bikerglen/halloween-grave-bell/mech/grave-bell-roof.dxf

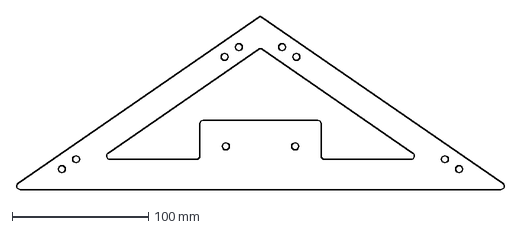
[picture p1: CAD file, 2021-09-14]
mech/grave-bell-roof.dxf
357.7 x 127.0 mm
