bikerglen/halloween-grave-bell/mech/ultrasonic sensor mount.dxf

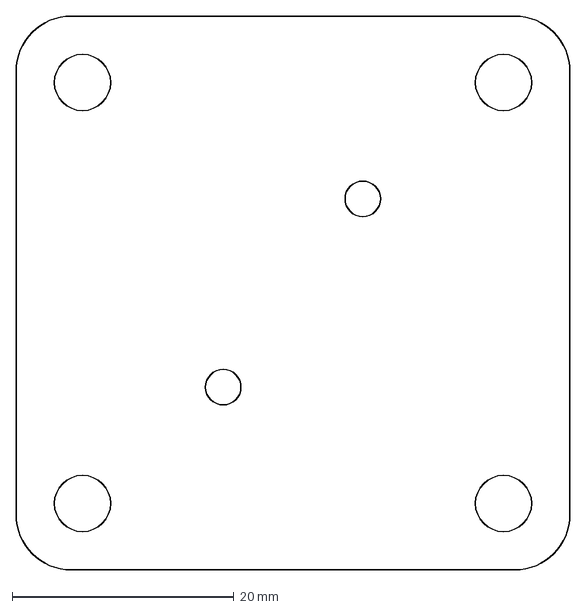
[picture p2: CAD file, 2021-09-14]
mech/ultrasonic sensor mount.dxf
50.0 x 50.0 mm
