bikerglen/halloween-grave-bell/mech/db9 power connector mount.dxf

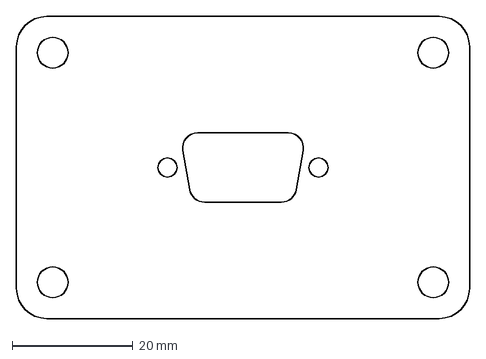
[picture p3: CAD file, 2021-09-14]
mech/db9 power connector mount.dxf
75.0 x 50.0 mm
