bikerglen/halloween-grave-bell/mech/board mount.dxf

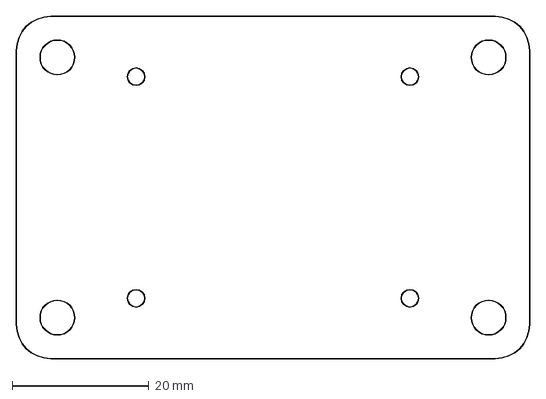
[picture p4: CAD file, 2021-09-14]
mech/board mount.dxf
75.0 x 50.0 mm
