bikerglen/halloween-grave-bell/hw/halloween-grave-bell-v02.brd

## EAGLE design hw/halloween-grave-bell-v02.brd (2021-09-05)

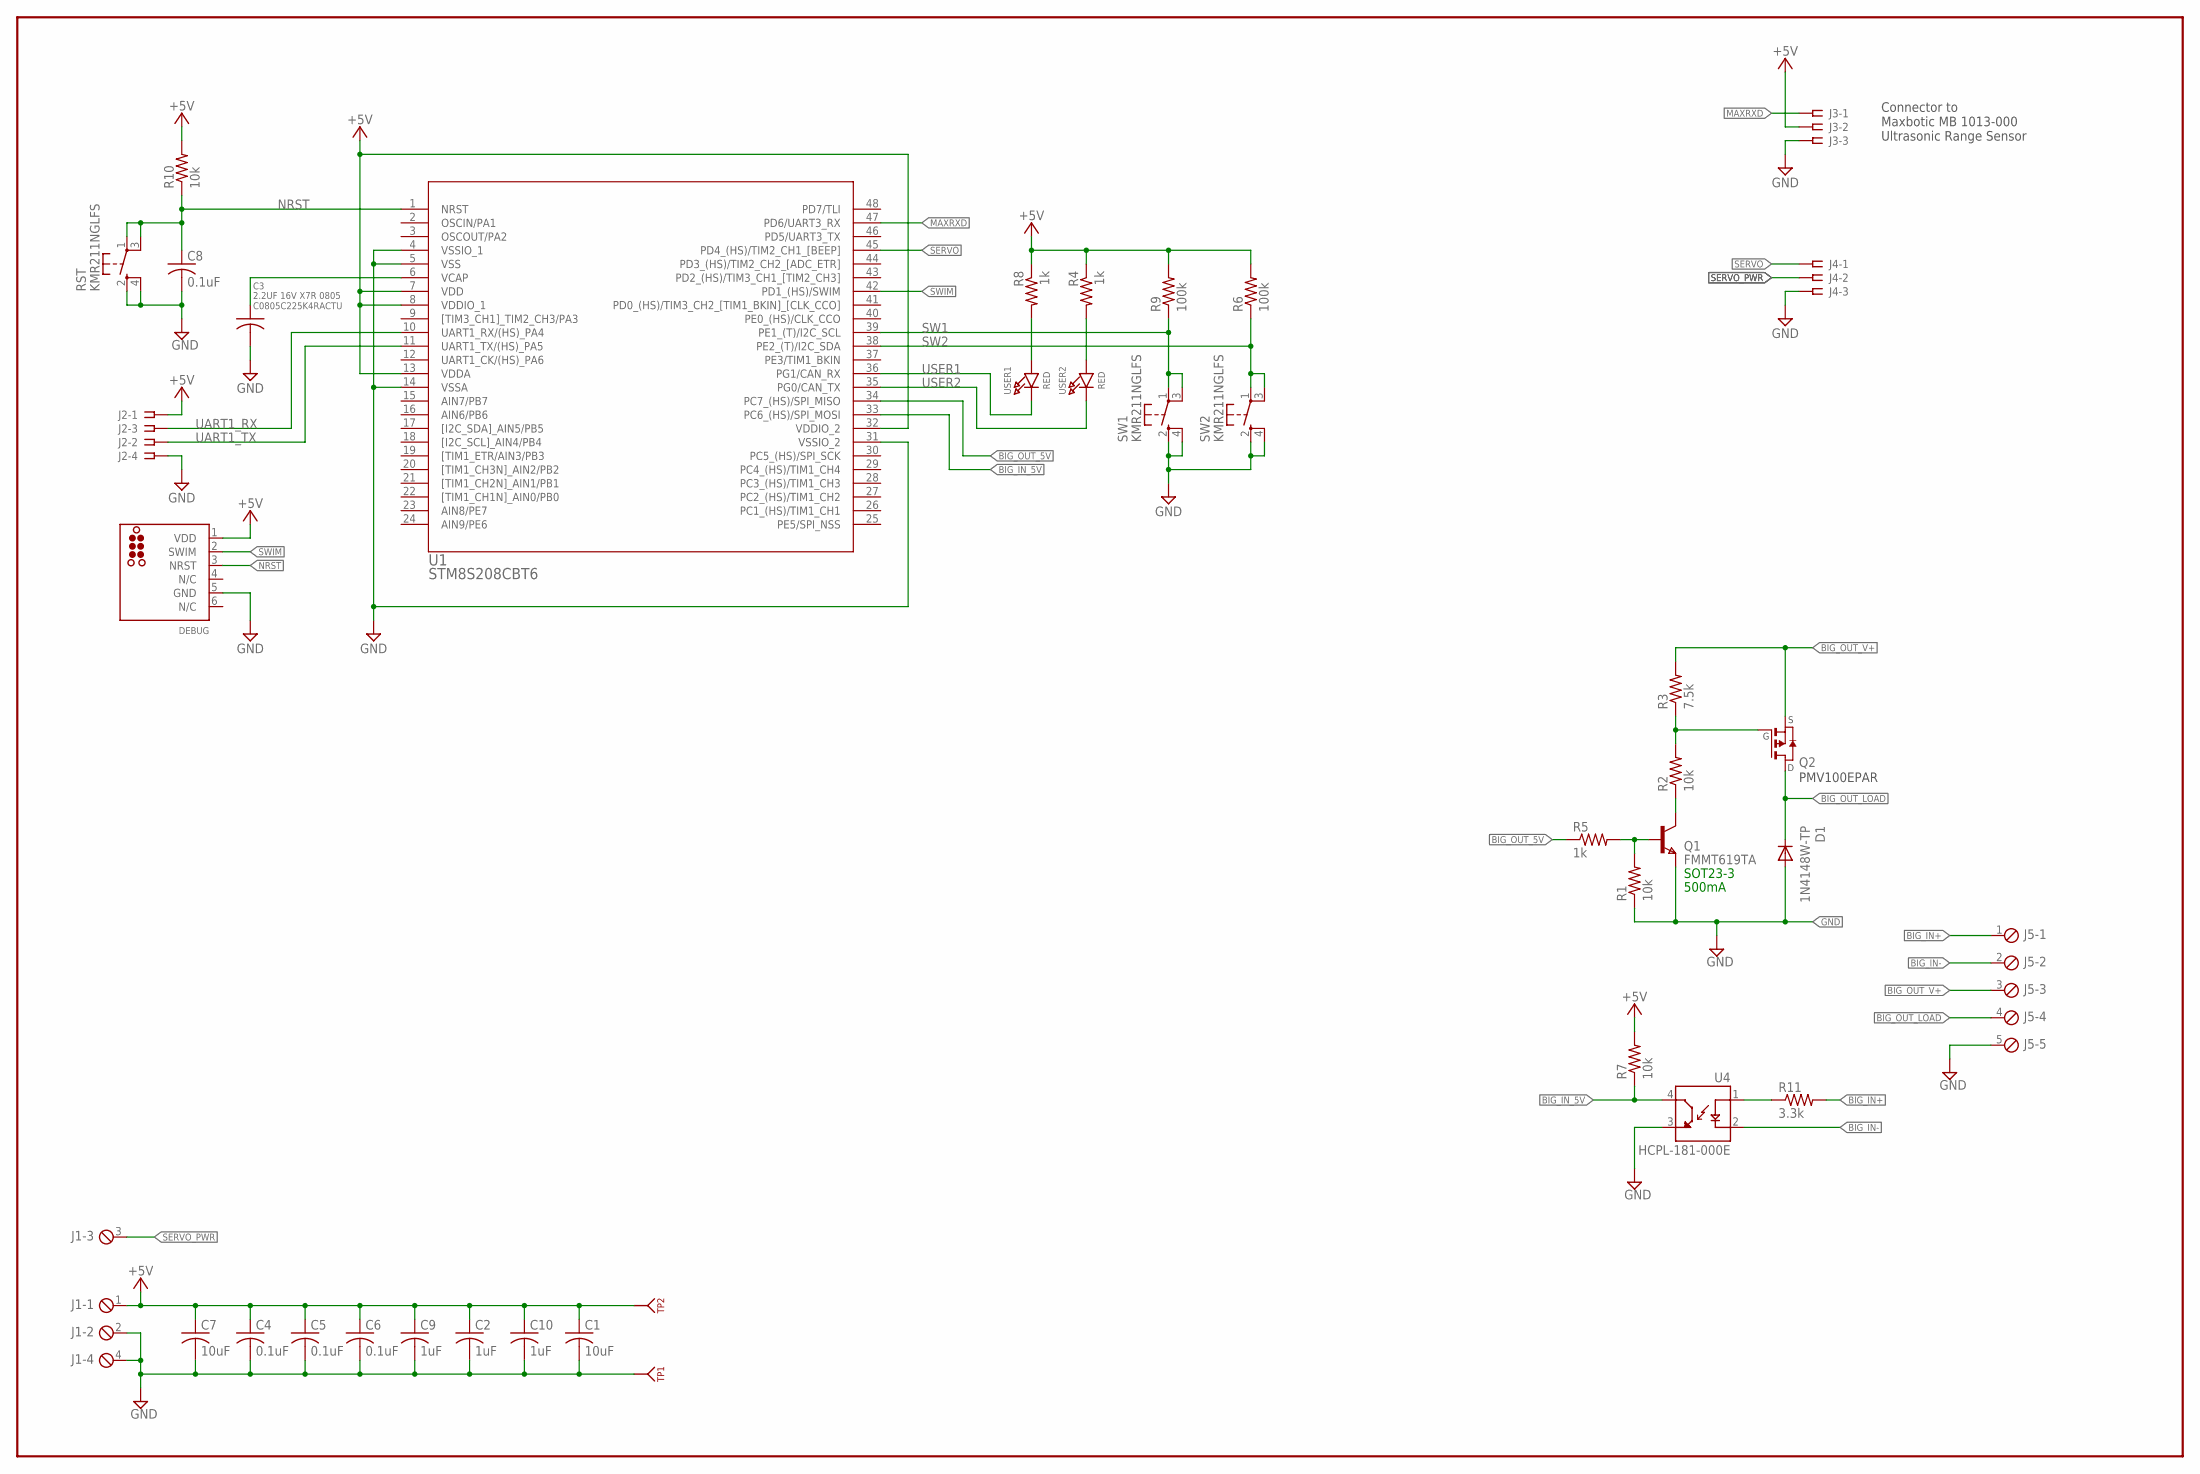
[picture p5: schematic halloween-grave-bell-v02.sch]

Parts:
C1, C7: 10uF; C1210; MFR_PART_NO C1210C105K4PACTU
C2, C9, C10: 1uF; C0603
C3: 2.2UF 16V X7R 0805; C0805; MFR_PART_NUM C0805C225K4RACTU
C4, C5, C6: 0.1uF; C0603
C8: 0.1uF; C0805
D1: 1N4148W-TP; SOD123
DEBUG: TC2030-NL-STM8; TC2030-NL
J1: MPT4; 4POL254
J2: SSW-104-02-S-S
J3, J4: SSW-103-02-S-S
J5: MPT5; 5POL254
Q1: FMMT619TA; SOT-23
Q2: PMOSSOT23; SOT-23
R1, R2, R7: 10k; R0603
R3: 7.5k; R0603
R4, R8: 1k; R0805
R5: 1k; R0603
R6, R9: 100k; R0805
R10: 10k; R0805
R11: 3.3k; R0603
RST: KMR211NGLFS; KMR2
SW1, SW2: KMR211NGLFS; KMR2
TP1, TP2: KEYSTONE_500X; KEYSTONE_TP500X
U1: STM8S208CBT6; LQFP-48_STM
U4: HCPL-181-000E; SOIC254P675X240-4N
USER1, USER2: RED; CHIPLED_0805_NOOUTLINE

Connections:
+5V: C1.1, C2.1, C4.1, C5.1, C6.1, C7.1, C9.1, C10.1, DEBUG.1 (VDD), J1.1, J2.1, J3.2, R4.1, R6.2, R7.2, R8.1, R9.2, R10.2, TP2.1, U1.7 (VDD), U1.8 (VDDIO_1), U1.13 (VDDA), U1.32 (VDDIO_2)
BIG_IN+: J5.1, R11.2
BIG_IN-: J5.2, U4.2 (CATHODE)
BIG_IN_5V: R7.1, U1.33 (PC6_(HS)/SPI_MOSI), U4.4 (COLLECTOR)
BIG_OUT_5V: R5.1, U1.34 (PC7_(HS)/SPI_MISO)
BIG_OUT_LOAD: D1.C, J5.4, Q2.1 (D)
BIG_OUT_V+: J5.3, Q2.2 (S), R3.2
GND: C1.2, C2.2, C3.2, C4.2, C5.2, C6.2, C7.2, C8.2, C9.2, C10.2, D1.A, DEBUG.5 (GND), J1.2, J1.4, J2.4, J3.3, J4.3, J5.5, Q1.2 (E), R1.1, RST.2 (S), RST.4 (S1), SW1.2 (S), SW1.4 (S1), SW2.2 (S), SW2.4 (S1), TP1.1, U1.4 (VSSIO_1), U1.5 (VSS), U1.14 (VSSA), U1.31 (VSSIO_2), U4.3 (EMITTER)
MAXRXD: J3.1, U1.47 (PD6/UART3_RX)
unnamed: Q1.1 (C), R2.1
unnamed: R8.2, USER1.A
unnamed: Q2.3 (G), R2.2, R3.1
unnamed: R4.2, USER2.A
unnamed: R11.1, U4.1 (ANODE)
unnamed: Q1.3 (B), R1.2, R5.2
NRST: C8.1, DEBUG.3 (NRST), R10.1, RST.1, RST.3 (P1), U1.1 (NRST)
SERVO: J4.1, U1.45 (PD4_(HS)/TIM2_CH1_[BEEP])
SERVO_PWR: J1.3, J4.2
SW1: R9.1, SW1.1, SW1.3 (P1), U1.39 (PE1_(T)/I2C_SCL)
SW2: R6.1, SW2.1, SW2.3 (P1), U1.38 (PE2_(T)/I2C_SDA)
SWIM: DEBUG.2 (SWIM), U1.42 (PD1_(HS)/SWIM)
UART1_RX: J2.3, U1.10 (UART1_RX/(HS)_PA4)
UART1_TX: J2.2, U1.11 (UART1_TX/(HS)_PA5)
USER1: U1.36 (PG1/CAN_RX), USER1.C
USER2: U1.35 (PG0/CAN_TX), USER2.C
VCAP: C3.1, U1.6 (VCAP)

Notes on the sheet:
SOT23-3
500mA
‎PMV100EPAR‎
Connector to Maxbotic MB 1013-000 Ultrasonic Range Sensor

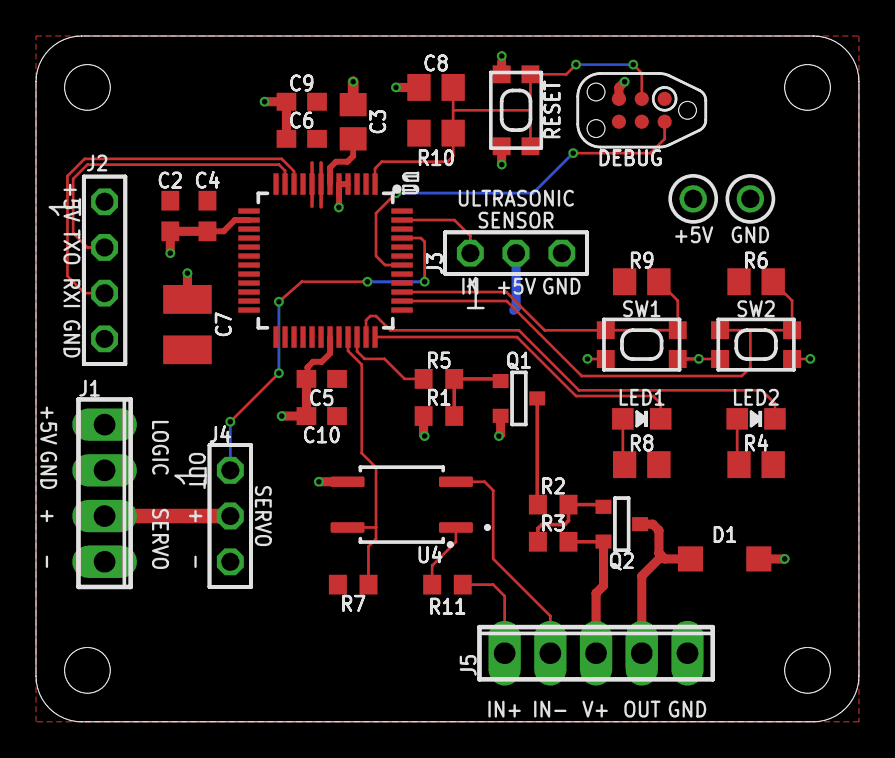
[picture p6: board halloween-grave-bell-v02.brd from above]

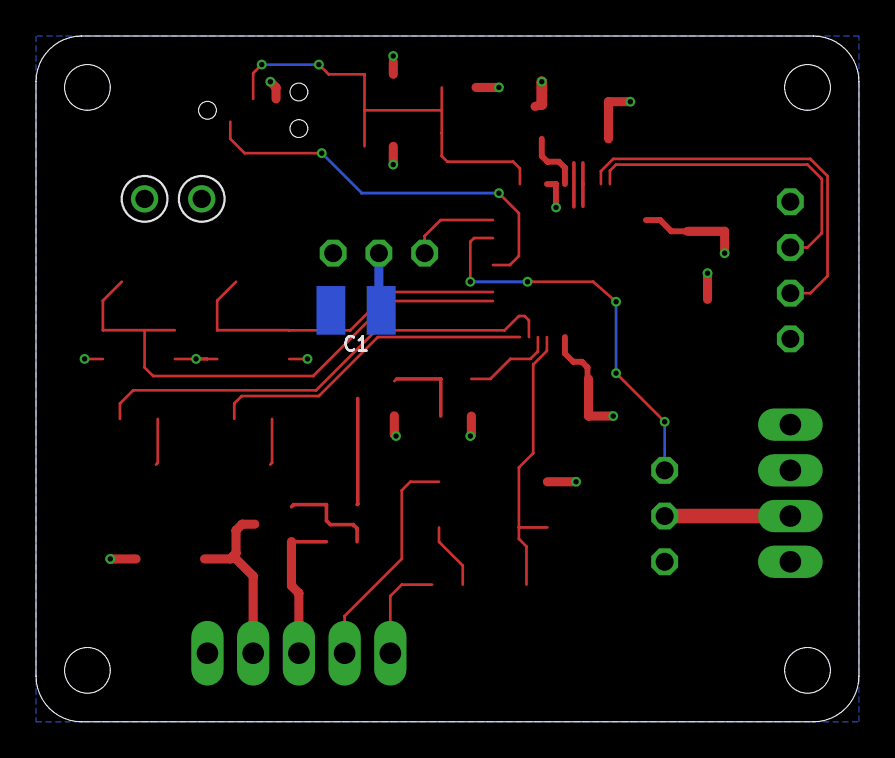
[picture p7: board halloween-grave-bell-v02.brd from below]

Board: 2 copper layers, 45.7 x 38.1 mm, 39 parts (3 on the bottom side), 26 nets.
