bikerglen/halloween-grave-bell/(commit log)

2020-12-24 added nucleo 64 board connections
2021-01-12 ported from nucleo eval board to real board
2021-09-05 add board design files
    [halloween-grave-bell-v02.brd, halloween-grave-bell-v02.sch]
2021-09-14 add dxf files for the metal bits
    [board mount.dxf, db9 power connector mount.dxf, grave-bell-roof.dxf, ultrasonic sensor mount.dxf]
